martonmiklos/ebus-adapter/ebus_adapter.kicad_pcb

## KiCad design ebus_adapter.kicad_pcb (2026-04-10)

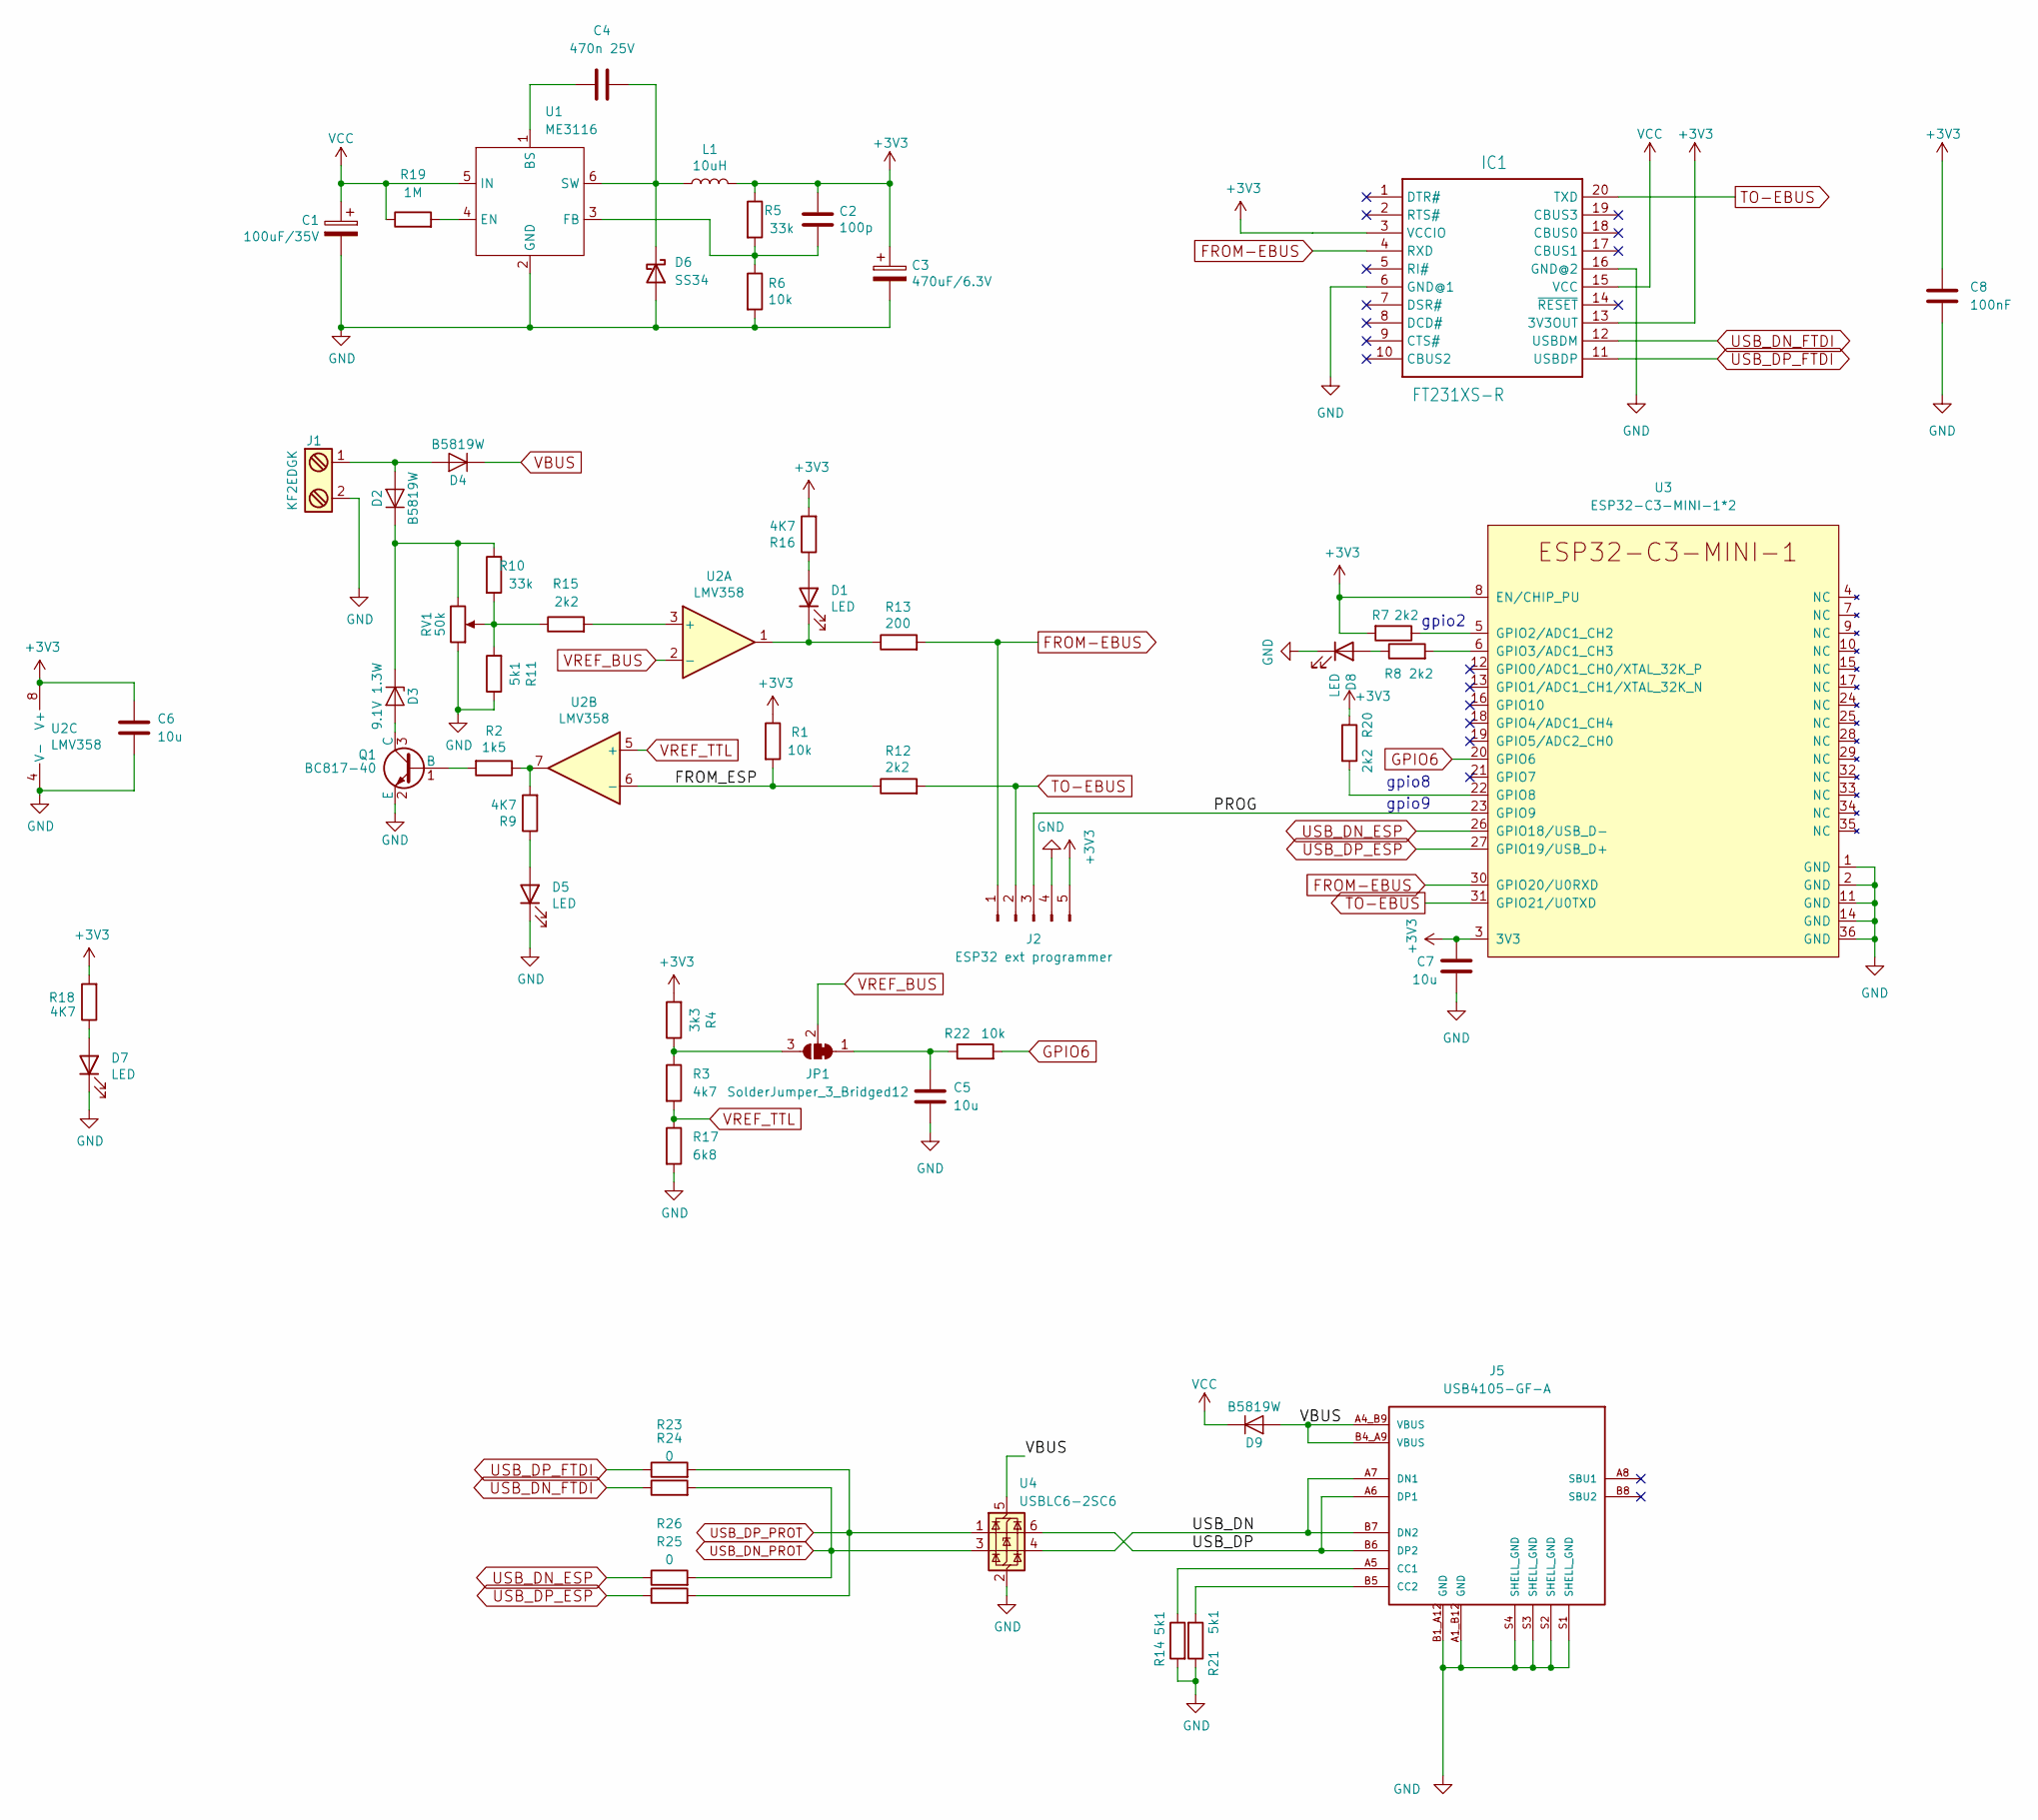
[picture p1: schematic ebus_adapter.kicad_sch]

Parts:
C1: 100uF/35V; CP_Elec_6.3x7.7; LCSC C240562
C2: 100p; C_0603_1608Metric; LCSC C14858
C3: 470uF/6.3V; CP_Elec_6.3x7.7; LCSC C3354
C4: 470n 25V; C_0603_1608Metric; LCSC C1623
C5, C6, C7: 10u; C_0603_1608Metric; LCSC C19702
C8: 100nF; C_0603_1608Metric; LCSC C19702
D1, D5, D7, D8: LED; LED_0603_1608Metric; LCSC C2286
D2, D4, D9: B5819W; D_SOD-123; LCSC C8598
D3: 9.1V 1.3W; D_MELF; LCSC C173488
D6: SS34; D_MELF; LCSC C8678
IC1: FT231XS-R; SOP63P599X175-20N
J1: KF2EDGK; CONN-TH_P5.08_HT508R-5.08-2P; LCSC C577832
J2: ESP32 ext programmer; PinHeader_1x05_P1.27mm_Vertical
J5: USB4105-GF-A; GCT_USB4105-GF-A_1; PARTREV A3
JP1: SolderJumper_3_Bridged12; SolderJumper-3_P1.3mm_Bridged12_RoundedPad1.0x1.5mm
L1: 10uH; L_Bourns-SRN6028; LCSC C9164
Q1: BC817-40; SOT-23; LCSC C2150
R1, R6, R22: 10k; R_0603_1608Metric; LCSC C25804
R2: 1k5; R_0603_1608Metric; LCSC C22843
R3: 4k7; R_0603_1608Metric; LCSC C23162
R4: 3k3; R_0603_1608Metric; LCSC C22978
R5, R10: 33k; R_0603_1608Metric; LCSC C4216
R7, R8, R12, R15, R20: 2k2; R_0603_1608Metric; LCSC C4190
R9, R16, R18: 4K7; R_0603_1608Metric; LCSC C4190
R11, R14, R21: 5k1; R_0603_1608Metric; LCSC C23186
R13: 200; R_0603_1608Metric; LCSC C8218
R17: 6k8; R_0603_1608Metric; LCSC C23212
R19: 1M; R_0603_1608Metric; LCSC C22935
R23, R24, R25, R26: 0; R_0603_1608Metric
RV1: 50k; Potentiometer_Bourns_3296W_Vertical; LCSC_IGNORE C118911
U1: ME3116; SOT-23-6; LCSC C97643
U2: LMV358; SOIC-8_3.9x4.9mm_P1.27mm; LCSC C63813
U3: ESP32-C3-MINI-1*2; ESP32-C3-MINI-1; LCSC C2934569
U4: USBLC6-2SC6; SOT-23-6

Connections:
+3V3: C2.1, C3.1, C6.1, C7.1, C8.1, IC1.3 (VCCIO), IC1.13 (3V3OUT), J2.5, L1.2, R1.1, R4.2, R5.1, R7.2, R16.2, R18.2, R20.1, U2.8 (V+), U3.3 (3V3), U3.8 (EN/CHIP_PU)
/FROM_ESP: R1.2, R12.1, U2.6 (-)
/PROG: J2.3, U3.23 (GPIO9)
/USB_DN: J5.A7 (DN1), J5.B7 (DN2), U4.4 (I/O2)
/USB_DP: J5.A6 (DP1), J5.B6 (DP2), U4.6 (I/O1)
FROM-EBUS: IC1.4 (RXD), J2.1, R13.2, U3.30 (GPIO20/U0RXD)
GND: C1.2, C3.2, C5.2, C6.2, C7.2, C8.2, D5.1 (K), D6.2 (A), D7.1 (K), D8.1 (K), IC1.6 (GND@1), IC1.16 (GND@2), J1.2, J2.4, J5.A1_B12 (GND), J5.B1_A12 (GND), J5.S1 (SHELL_GND), J5.S2 (SHELL_GND), J5.S3 (SHELL_GND), J5.S4 (SHELL_GND), Q1.2 (E), R6.2, R11.1, R14.2, R17.2, R21.1, RV1.1, U1.2 (GND), U2.4 (V-), U3.1 (GND), U3.2 (GND), U3.11 (GND), U3.14 (GND), U3.36 (GND), U4.2 (GND)
GPIO6: R22.2, U3.20 (GPIO6)
unnamed: D1.2 (A), R16.1
unnamed: D1.1 (K), R13.1, U2.1
unnamed: D2.2 (A), D4.2 (A), J1.1
unnamed: D2.1 (K), D3.1 (K), R10.1, RV1.3
unnamed: D3.2 (A), Q1.3 (C)
unnamed: D5.2 (A), R9.1
unnamed: C4.2, D6.1 (K), L1.1, U1.6 (SW)
unnamed: D7.2 (A), R18.1
unnamed: D8.2 (A), R8.1
unnamed: J5.A5 (CC1), R14.1
unnamed: J5.B5 (CC2), R21.2
unnamed: C5.1, JP1.1 (A), R22.1
unnamed: JP1.3 (B), R3.1, R4.1
unnamed: Q1.1 (B), R2.2
unnamed: R2.1, R9.2, U2.7
unnamed: R10.2, R11.2, R15.1, RV1.2
unnamed: C4.1, U1.1 (BS)
unnamed: R19.2, U1.4 (EN)
unnamed: C2.2, R5.2, R6.1, U1.3 (FB)
unnamed: R15.2, U2.3 (+)
unnamed: R7.1, U3.5 (GPIO2/ADC1_CH2)
unnamed: R8.2, U3.6 (GPIO3/ADC1_CH3)
unnamed: R20.2, U3.22 (GPIO8)
TO-EBUS: IC1.20 (TXD), J2.2, R12.2, U3.31 (GPIO21/U0TXD)
USB_DN_ESP: R26.1, U3.26 (GPIO18/USB_D-)
USB_DN_FTDI: IC1.12 (USBDM), R24.1
USB_DN_PROT: R24.2, R26.2, U4.3 (I/O2)
USB_DP_ESP: R25.1, U3.27 (GPIO19/USB_D+)
USB_DP_FTDI: IC1.11 (USBDP), R23.1
USB_DP_PROT: R23.2, R25.2, U4.1 (I/O1)
VBUS: D4.1 (K), D9.2 (A), J5.A4_B9 (VBUS), J5.B4_A9 (VBUS), U4.5 (VBUS)
VCC: C1.1, D9.1 (K), IC1.15 (VCC), R19.1, U1.5 (IN)
VREF_BUS: JP1.2 (C), U2.2 (-)
VREF_TTL: R3.2, R17.1, U2.5 (+)

Notes on the sheet:
gpio2
gpio8
gpio9

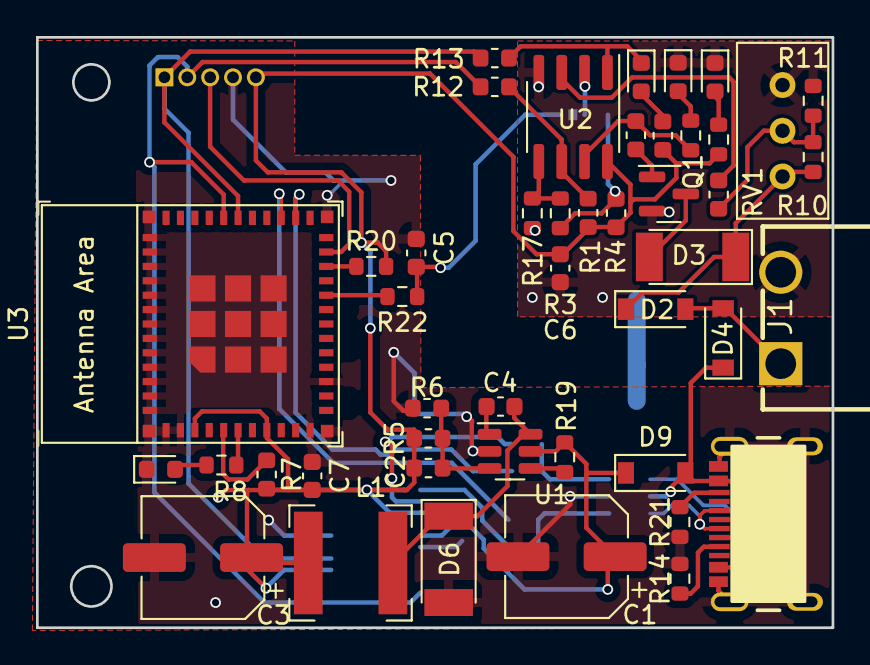
[picture p2: board ebus_adapter.kicad_pcb from above]

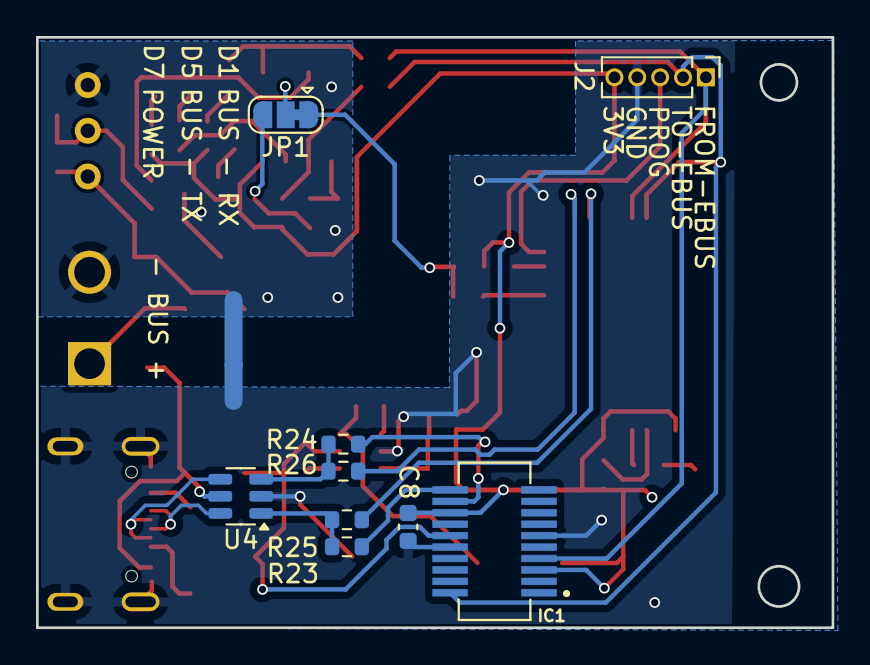
[picture p3: board ebus_adapter.kicad_pcb from below]

Board: 2 copper layers, 44.2 x 32.8 mm, 55 parts (9 on the bottom side), 42 nets.
